Things-Maker/R.A.E.D/Upgrades/Heatbed Relay Wiring/relay.jpg

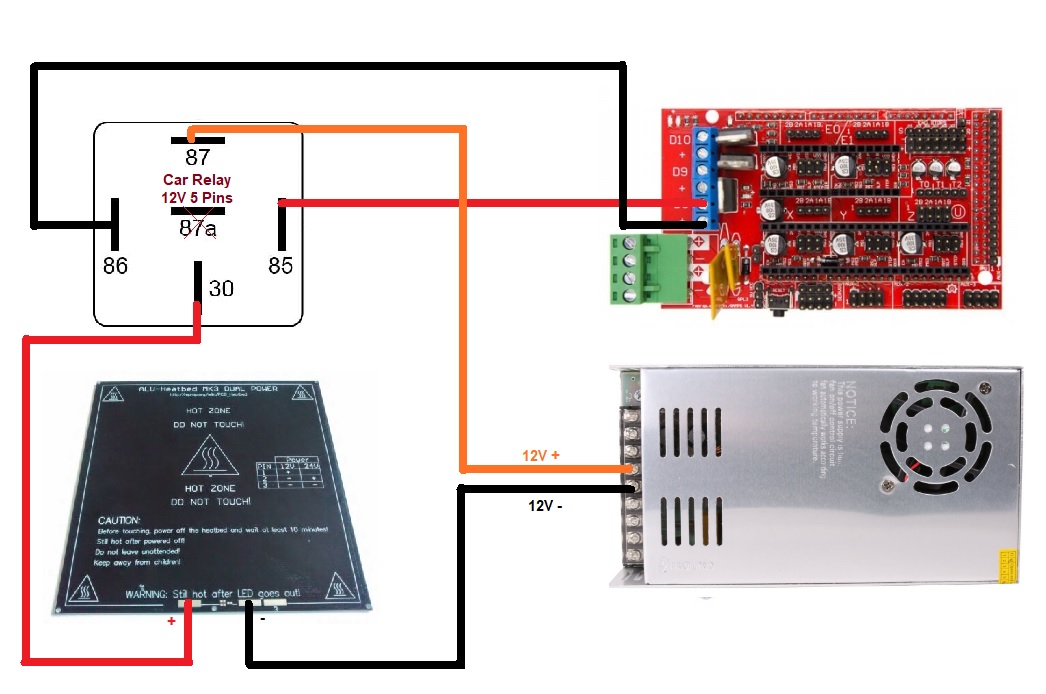
Upgrades/Heatbed Relay Wiring/relay.jpg
