Things-Maker/R.A.E.D/Upgrades/Autoleveling/Wiring/SN04abl.jpg

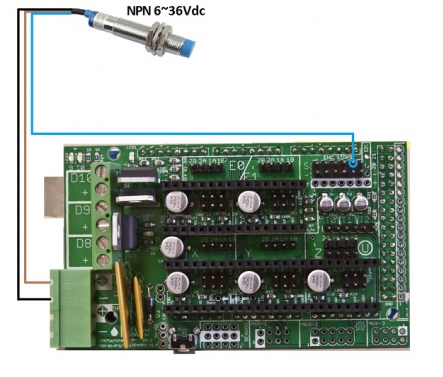
Upgrades/Autoleveling/Wiring/SN04abl.jpg
