Things-Maker/R.A.E.D/README.md

# R.A.E.D
 An Easy to build Tronxy X1 Style 3d printer that is designed to be cut by laser cutters
