Things-Maker/R.A.E.D/Pics/2.png

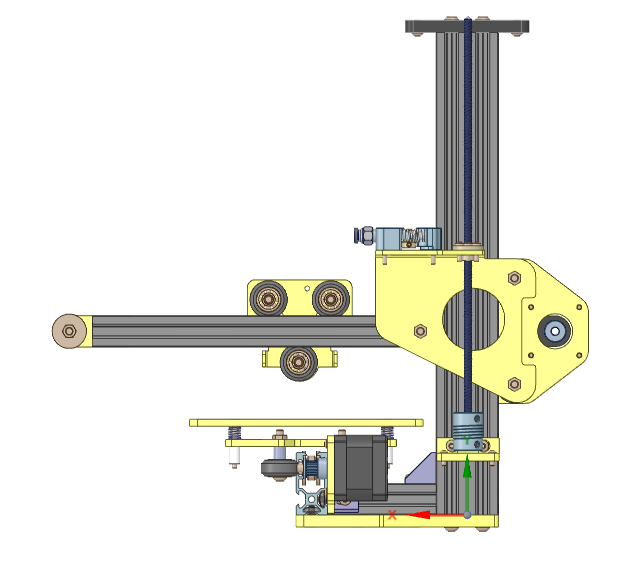
Pics/2.png
