Things-Maker/R.A.E.D/Pics/3.png

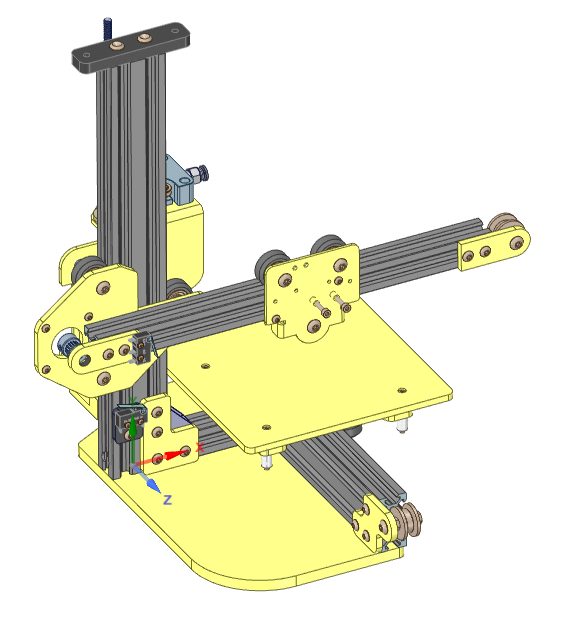
Pics/3.png
