Things-Maker/R.A.E.D/Upgrades/Bed_Tightner/bed.png

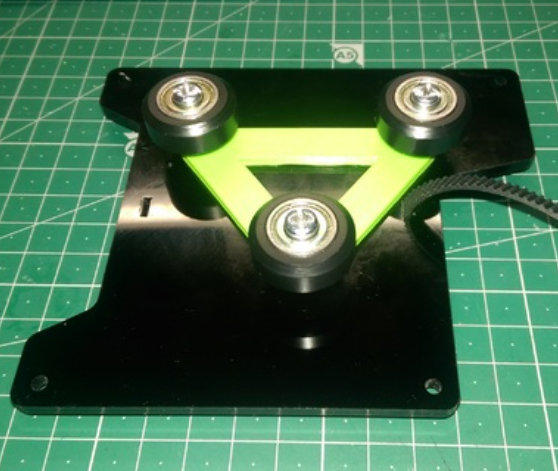
Upgrades/Bed_Tightner/bed.png
