Things-Maker/R.A.E.D/Upgrades/Belt_Tightner/tight.png

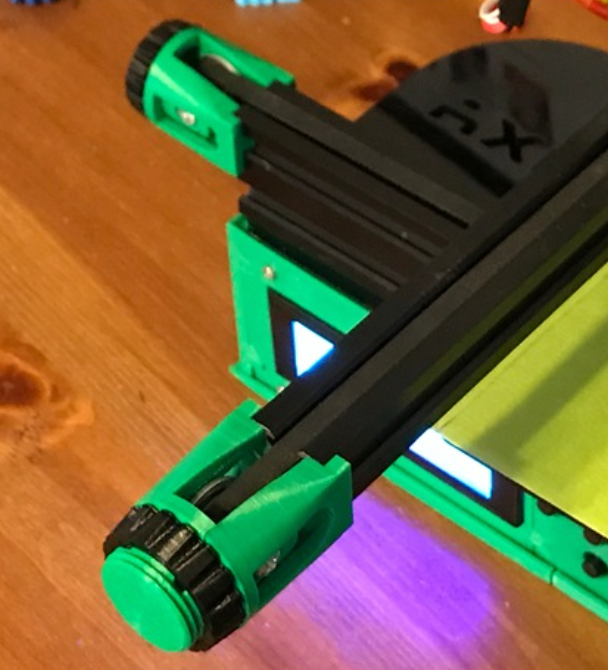
Upgrades/Belt_Tightner/tight.png
