Things-Maker/R.A.E.D/Upgrades/Extruder/New Extruder Bondtech/032b2cc936860b03048302d991c3498f.jpg

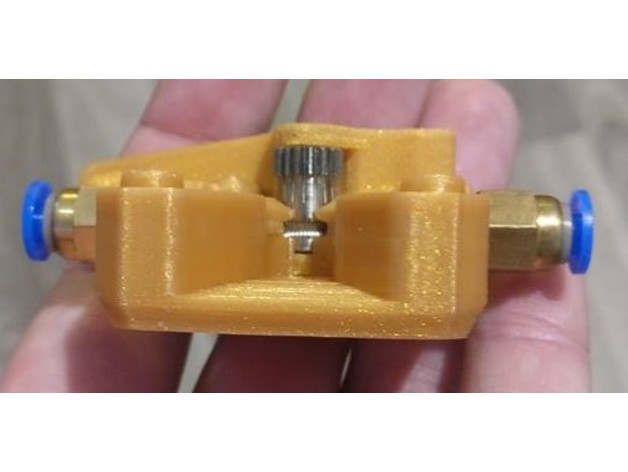
Upgrades/Extruder/New Extruder Bondtech/032b2cc936860b03048302d991c3498f.jpg
