Things-Maker/R.A.E.D/Upgrades/Extruder/New Extruder Bondtech/799bad5a3b514f096e69bbc4a7896cd9.jpg

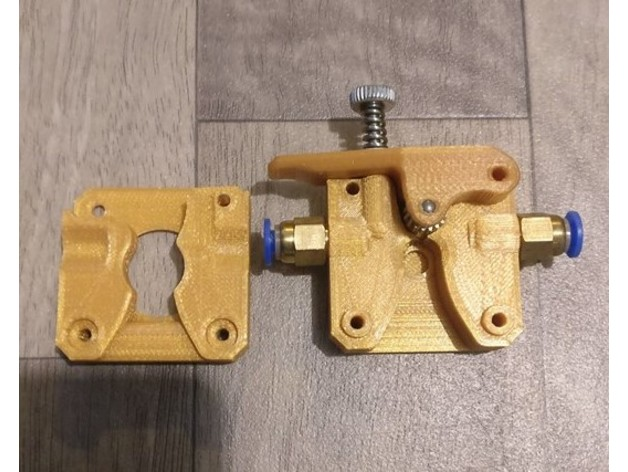
Upgrades/Extruder/New Extruder Bondtech/799bad5a3b514f096e69bbc4a7896cd9.jpg
