Things-Maker/R.A.E.D/Upgrades/Extruder/New Extruder Bondtech/156005c5baf40ff51a327f1c34f2975b.jpg

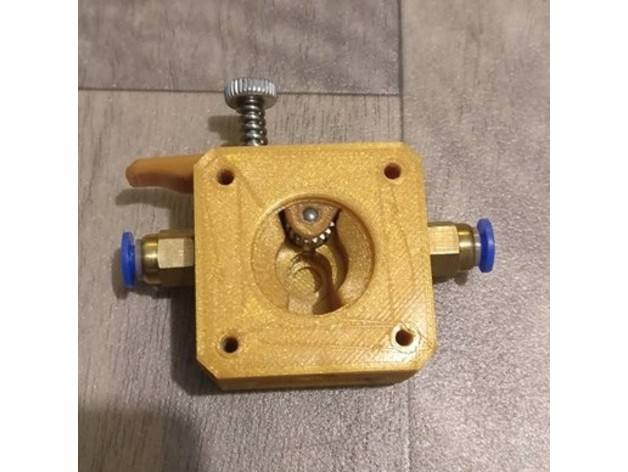
Upgrades/Extruder/New Extruder Bondtech/156005c5baf40ff51a327f1c34f2975b.jpg
