Things-Maker/R.A.E.D/Upgrades/Extruder/New Extruder Bondtech/d0096ec6c83575373e3a21d129ff8fef.jpg

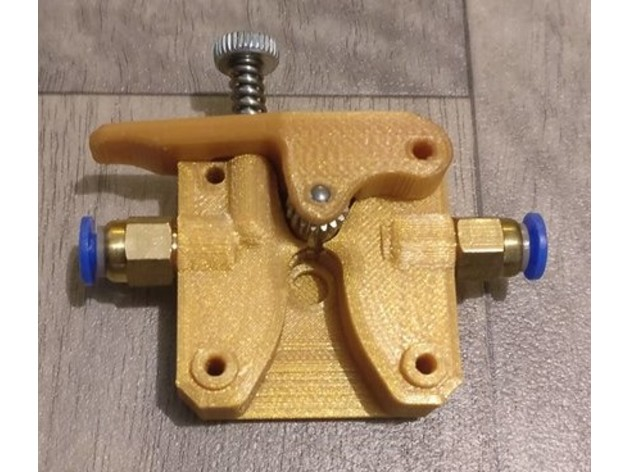
Upgrades/Extruder/New Extruder Bondtech/d0096ec6c83575373e3a21d129ff8fef.jpg
