Things-Maker/R.A.E.D/Upgrades/Extruder/New Extruder Bondtech/f3ccdd27d2000e3f9255a7e3e2c48800.jpg

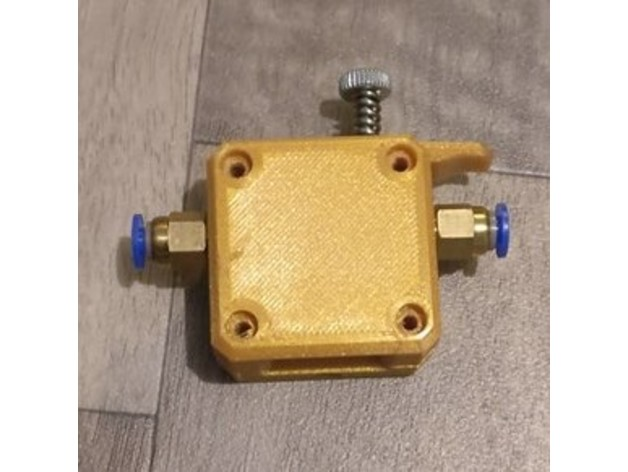
Upgrades/Extruder/New Extruder Bondtech/f3ccdd27d2000e3f9255a7e3e2c48800.jpg
