Things-Maker/R.A.E.D/Upgrades/Phone Holder (Camera-Octoprint)/Phone Holder.png

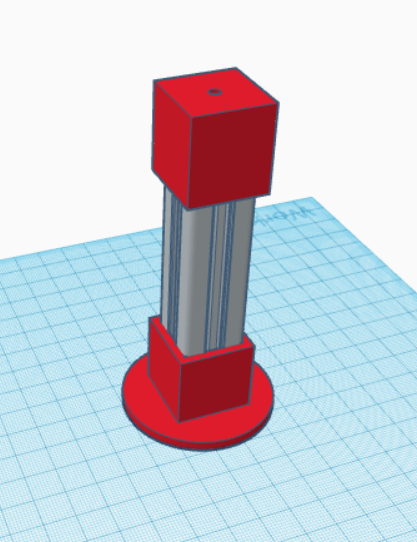
Upgrades/Phone Holder (Camera-Octoprint)/Phone Holder.png
