Things-Maker/R.A.E.D/Upgrades/Z_Carriage_Tightner/Z_tight.png

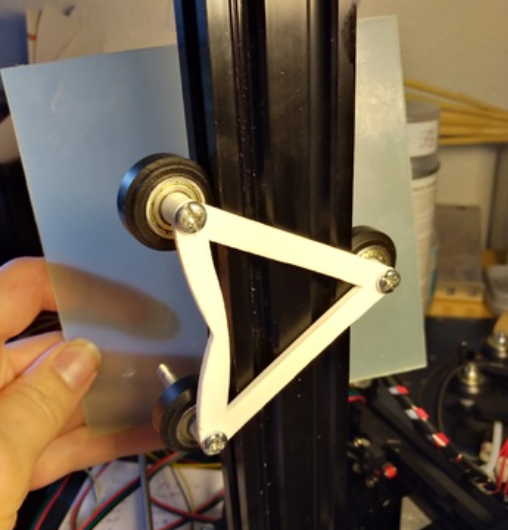
Upgrades/Z_Carriage_Tightner/Z_tight.png
