Things-Maker/R.A.E.D/Upgrades/Z_Motor_Mount/Z_Motor.png

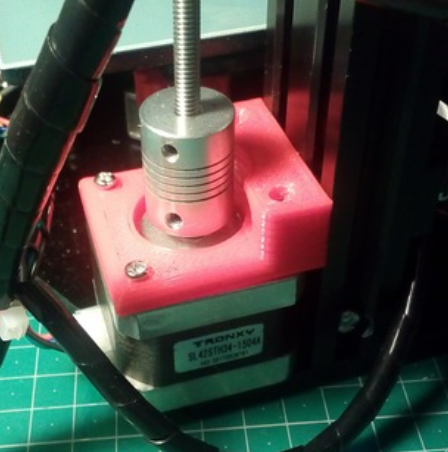
Upgrades/Z_Motor_Mount/Z_Motor.png
