Things-Maker/R.A.E.D/Upgrades/Z_X_Carriage/Z.png

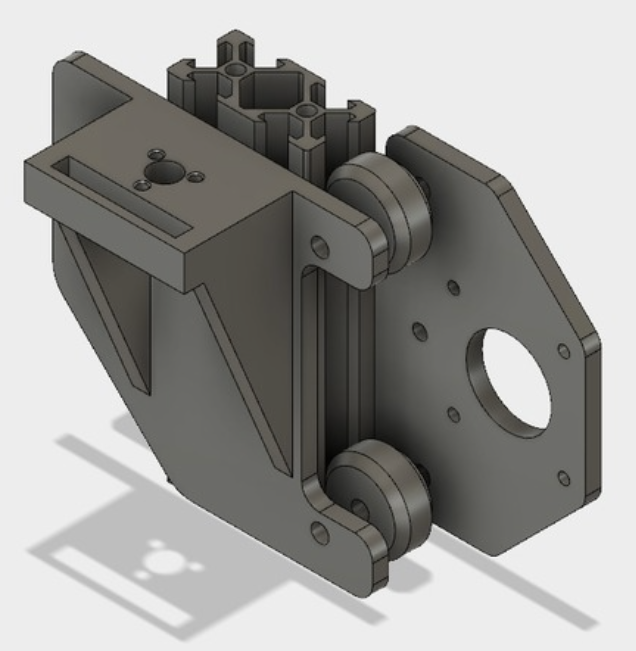
Upgrades/Z_X_Carriage/Z.png
