Things-Maker/R.A.E.D/Part_List/Part_List.xlsx

Part Name | Quantity | Price USD | Link
2040 Aluminum profile | 600mm Tslot or Vslot | 12.36 | https://bityl.co/FSdF
2020 Aluminum Profile | 400mm Tslot or Vslot | 5.38 | https://bityl.co/FSdF
Openbuilds Wheels (Big) | 9 | 7.12 | https://bityl.co/FSdO
GT2 Belt And Pully Kit | 1 | 3.34 | https://bityl.co/FSdY
Nema17 Motor | 3 | 8.16 | https://bityl.co/FSeJ
5x8 Shaft Coupler | 1 | 0.34 | https://bityl.co/FSeK
LeadScrew With Nut | 250mm - M8 | 3.96 | https://bityl.co/FSeP
Endstop Switchs | 3 | 1.12 | https://bityl.co/FSeZ
Full Assembled Extruder | 1 | 9.35 | https://bityl.co/FSfn
Metal Extruder Full Kit | 1 | 5.26 | https://bityl.co/FSfs
M4 M5 Nut Bolt Kit | 1 | 6.92 | https://bityl.co/FSfw
Electronics Kit | 1 | 17.85 | https://bityl.co/FSgy
Aluminum 2020 Corner Bracket | 10 | 2.01 | https://bityl.co/FSgY | Optional
X Carriage Plate with wheels | 1 | 3.87 | https://bityl.co/FSfd | Optional
Laser Cutting + Wood 6mm | 250x500mm | 18.5 | Local store | Optional
Power Supply | 12V 6Amp | 4 | https://bityl.co/FSh6 | Optional
 | TOTAL | 109.54
