Things-Maker/R.A.E.D/Calibration Steps/xyzCalibration_cube.stl

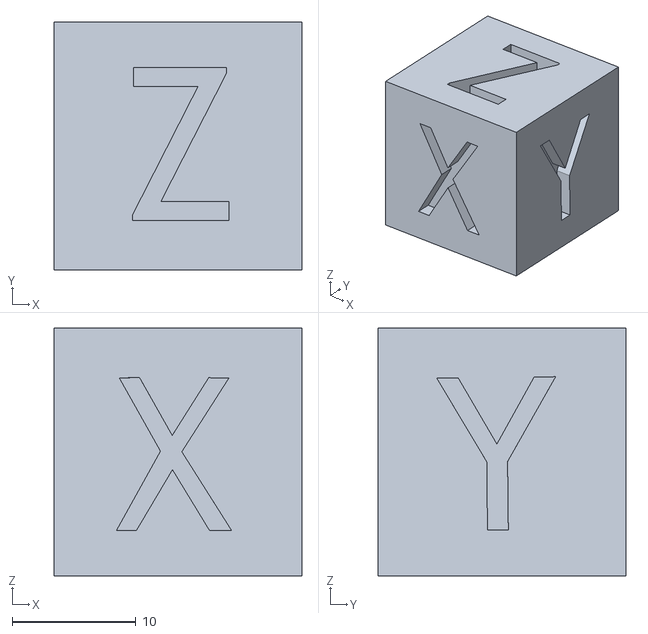
[picture p16: CAD file, 2023-03-04]
Calibration Steps/xyzCalibration_cube.stl
20.0 x 20.0 x 20.0
