Things-Maker/R.A.E.D/R.A.E.D_For_3DPrint/All_small_Parts.stl

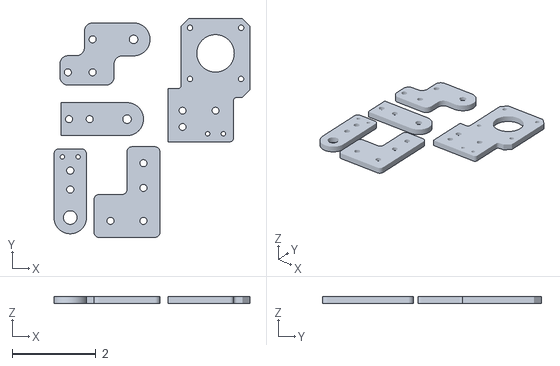
[picture p17: CAD file, 2023-03-04]
R.A.E.D_For_3DPrint/All_small_Parts.stl
4.68 x 5.22 x 0.177
