Things-Maker/R.A.E.D/Upgrades/Autoleveling/Mount/SN04_sensor_Mount.stl

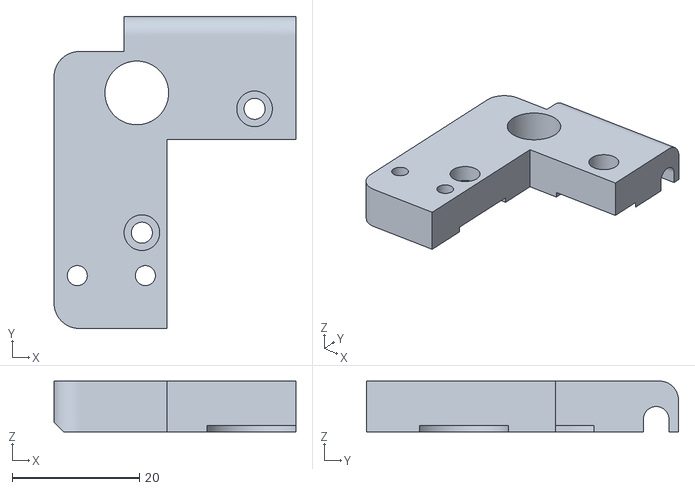
[picture p18: CAD file, 2023-03-04]
Upgrades/Autoleveling/Mount/SN04_sensor_Mount.stl
38.0 x 49.0 x 8.00
