Things-Maker/R.A.E.D/Upgrades/Bed_Tightner/bed_tightner_Up.stl

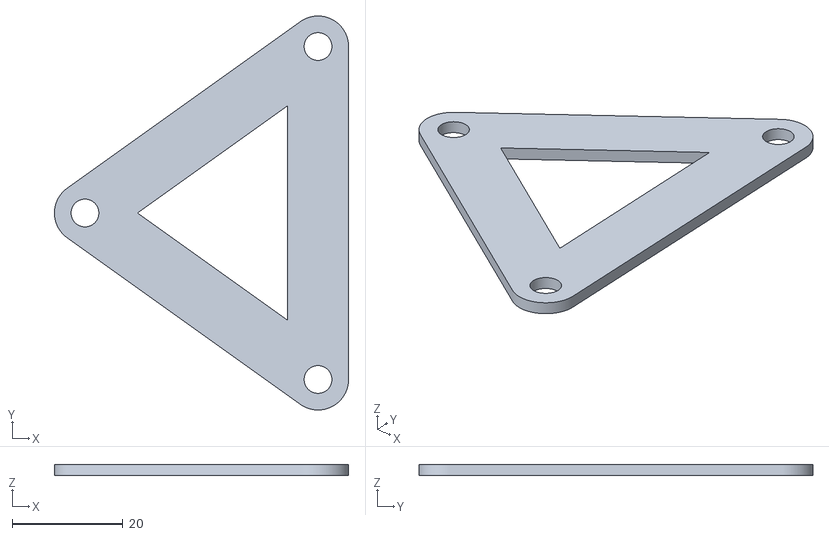
[picture p19: CAD file, 2023-03-04]
Upgrades/Bed_Tightner/bed_tightner_Up.stl
53.0 x 71.0 x 2.00
