Things-Maker/R.A.E.D/Upgrades/Electronics_Box/lcd_front.stl

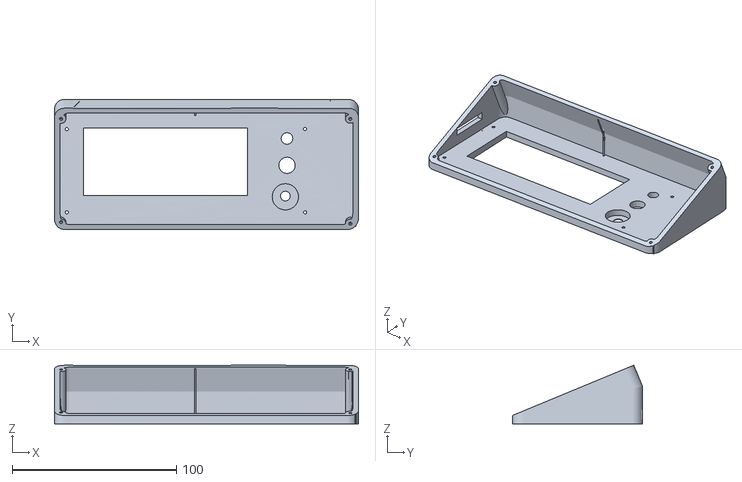
[picture p20: CAD file, 2023-03-04]
Upgrades/Electronics_Box/lcd_front.stl
185.0 x 79.2 x 35.6
