Things-Maker/R.A.E.D/Upgrades/Extruder/New Extruder Bondtech/STL/extruder-haut.STL

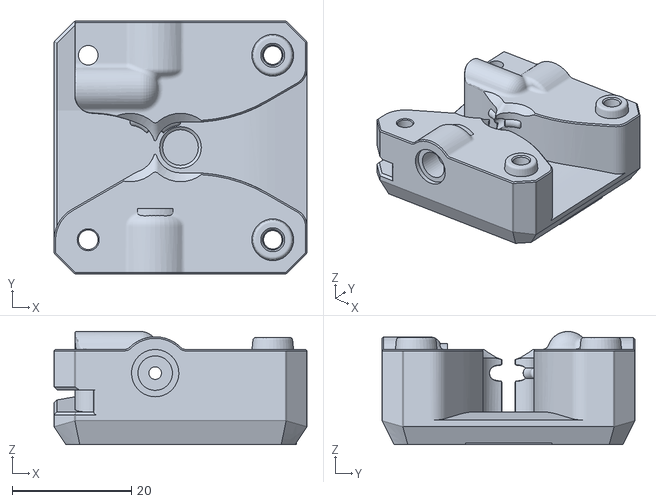
[picture p21: CAD file, 2023-03-04]
Upgrades/Extruder/New Extruder Bondtech/STL/extruder-haut.STL
42.5 x 42.5 x 19.0
