Things-Maker/R.A.E.D/Upgrades/Phone Holder (Camera-Octoprint)/Phone Holder.stl

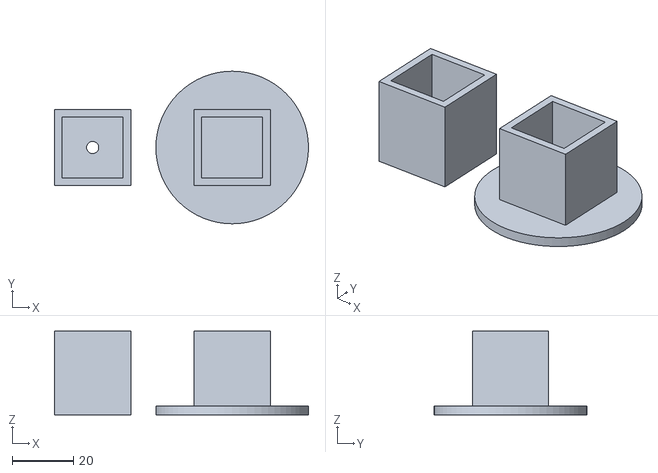
[picture p22: CAD file, 2023-03-04]
Upgrades/Phone Holder (Camera-Octoprint)/Phone Holder.stl
83.2 x 50.0 x 27.5
