Things-Maker/R.A.E.D/Upgrades/Z_Carriage_Tightner/Carriage_Tightner_2.stl

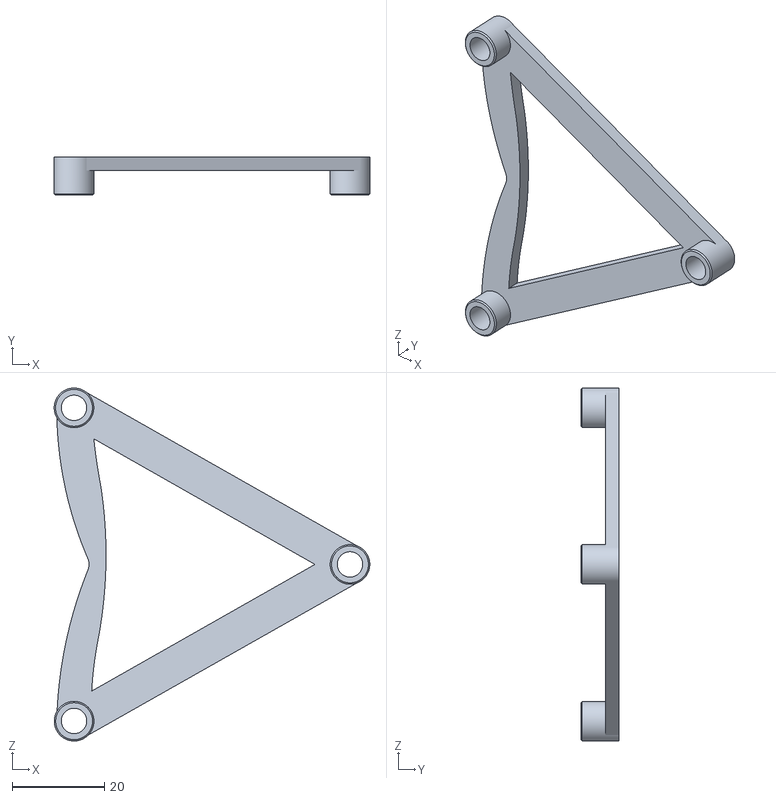
[picture p23: CAD file, 2023-03-04]
Upgrades/Z_Carriage_Tightner/Carriage_Tightner_2.stl
68.4 x 8.30 x 76.5
