Things-Maker/R.A.E.D/Upgrades/Z_Motor_Mount/z_motor_mount.stl

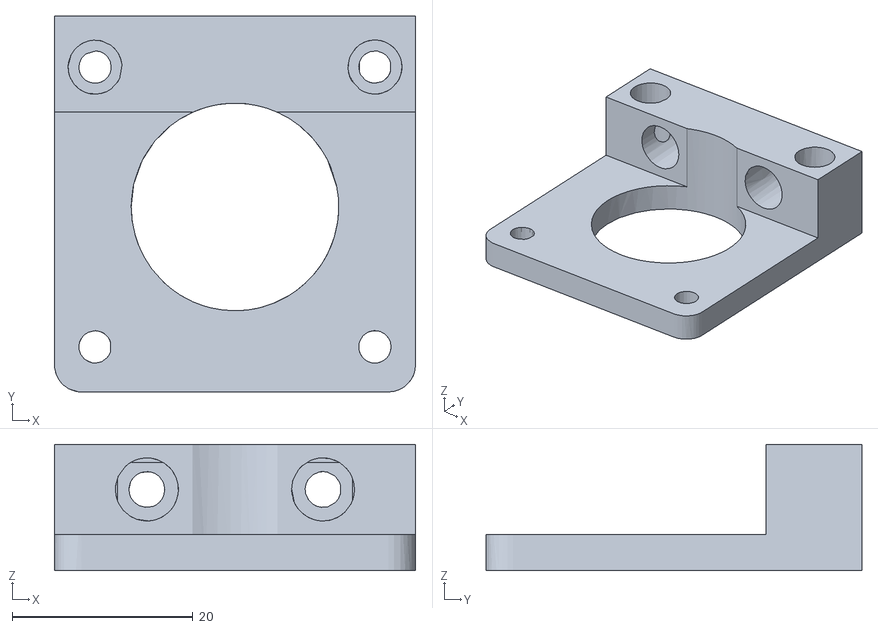
[picture p24: CAD file, 2023-03-04]
Upgrades/Z_Motor_Mount/z_motor_mount.stl
40.0 x 41.7 x 14.0
