Things-Maker/R.A.E.D/Upgrades/Z_X_Carriage/STL/Carriage_Upgrade_1.stl

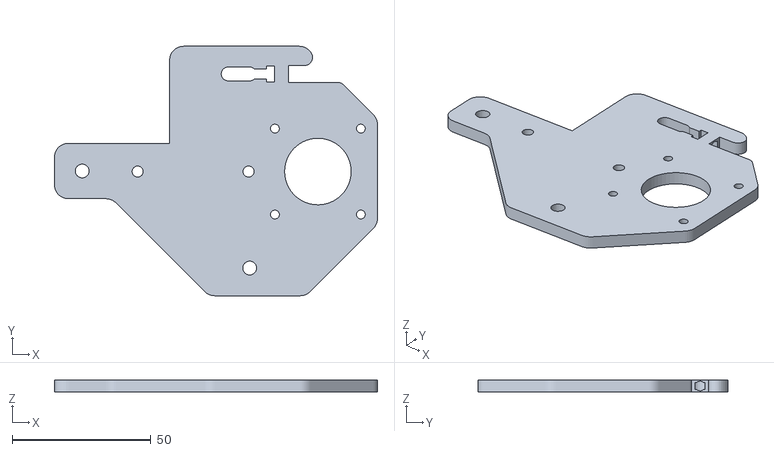
[picture p25: CAD file, 2023-03-04]
Upgrades/Z_X_Carriage/STL/Carriage_Upgrade_1.stl
116.5 x 90.0 x 4.50
