Things-Maker/R.A.E.D/R.A.E.D_For_3DPrint/Extruder.stl

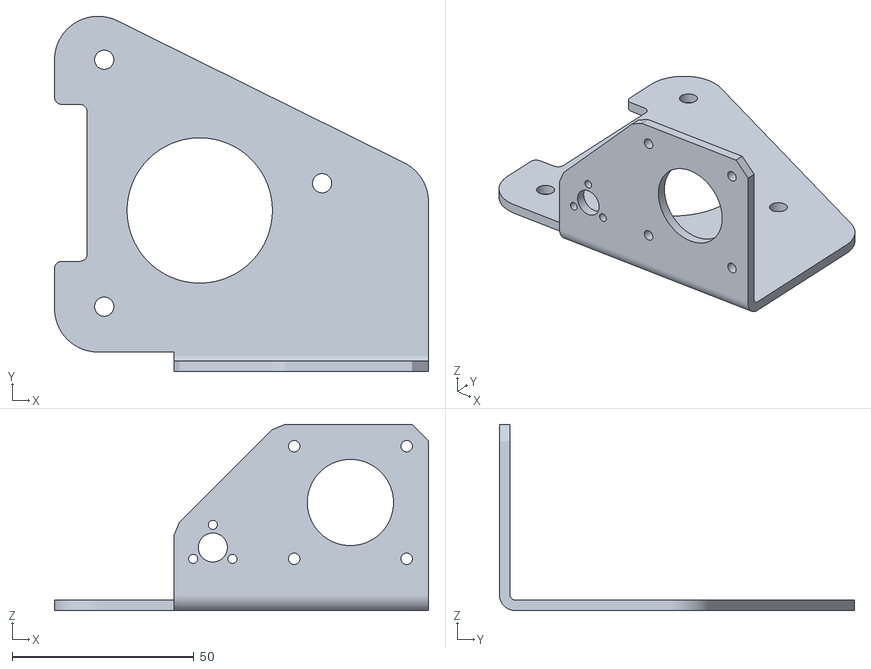
[picture p26: CAD file, 2023-03-04]
R.A.E.D_For_3DPrint/Extruder.stl
103.0 x 97.9 x 51.3
