Things-Maker/R.A.E.D/Upgrades/Bed_Tightner/bed_tightner_Down.stl

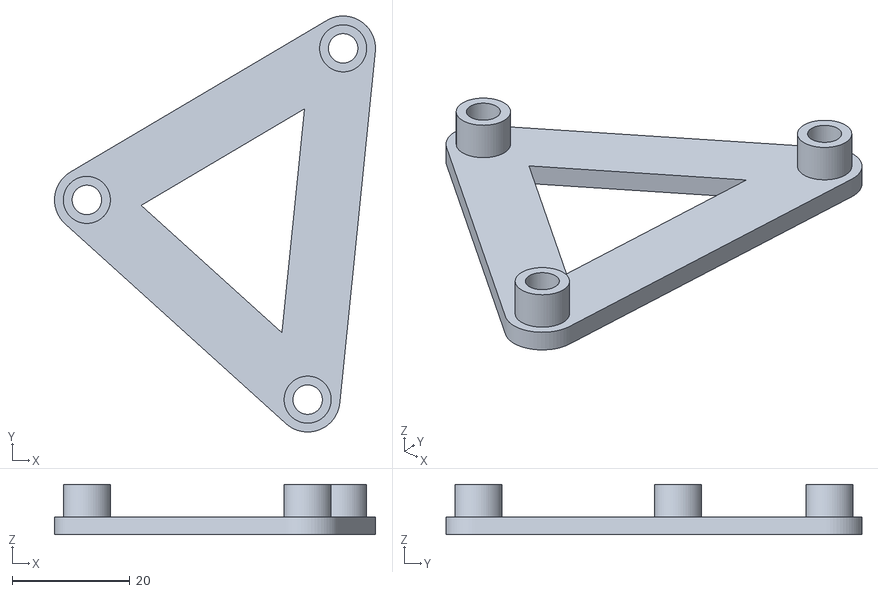
[picture p27: CAD file, 2023-03-04]
Upgrades/Bed_Tightner/bed_tightner_Down.stl
54.6 x 70.7 x 8.50
