Things-Maker/R.A.E.D/Upgrades/Electronics_Box/stop_button.stl

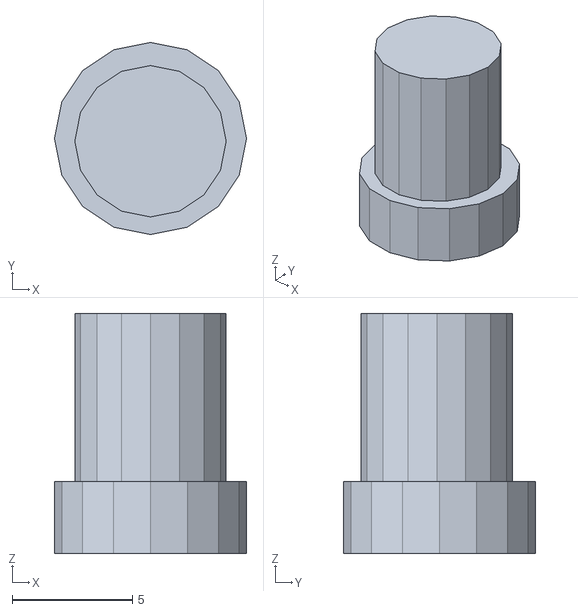
[picture p28: CAD file, 2023-03-04]
Upgrades/Electronics_Box/stop_button.stl
8.00 x 8.00 x 10.00
