Things-Maker/R.A.E.D/Upgrades/Extruder/New Extruder Bondtech/STL/extruder-languette.STL

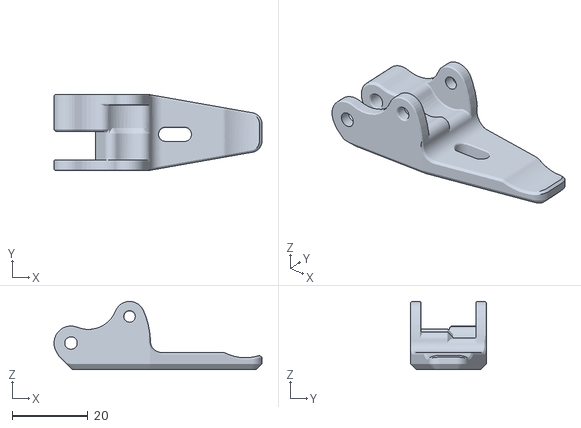
[picture p29: CAD file, 2023-03-04]
Upgrades/Extruder/New Extruder Bondtech/STL/extruder-languette.STL
55.0 x 20.0 x 18.0
