Things-Maker/R.A.E.D/Upgrades/Z_X_Carriage/STL/Carriage_Upgrade_2.stl

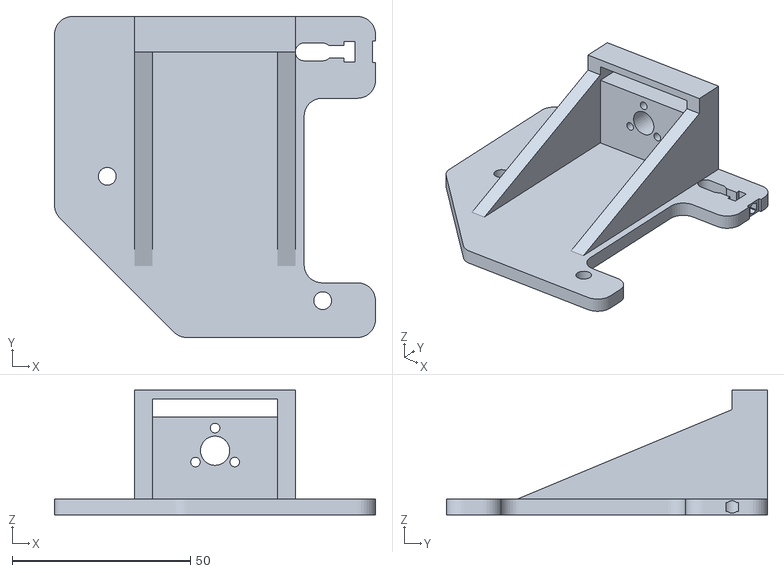
[picture p30: CAD file, 2023-03-04]
Upgrades/Z_X_Carriage/STL/Carriage_Upgrade_2.stl
90.0 x 90.0 x 35.0
