Things-Maker/R.A.E.D/R.A.E.D_For_3DPrint/Bed_Plate.stl

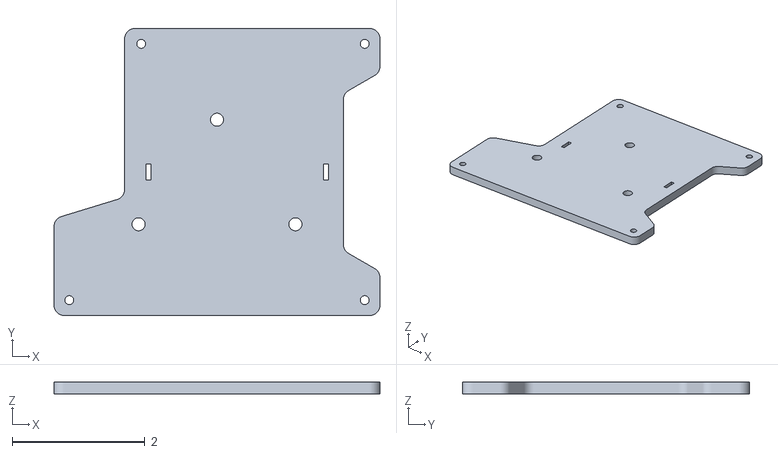
[picture p31: CAD file, 2023-03-04]
R.A.E.D_For_3DPrint/Bed_Plate.stl
4.91 x 4.32 x 0.177
