Things-Maker/R.A.E.D/Upgrades/Electronics_Box/lcd_base.stl

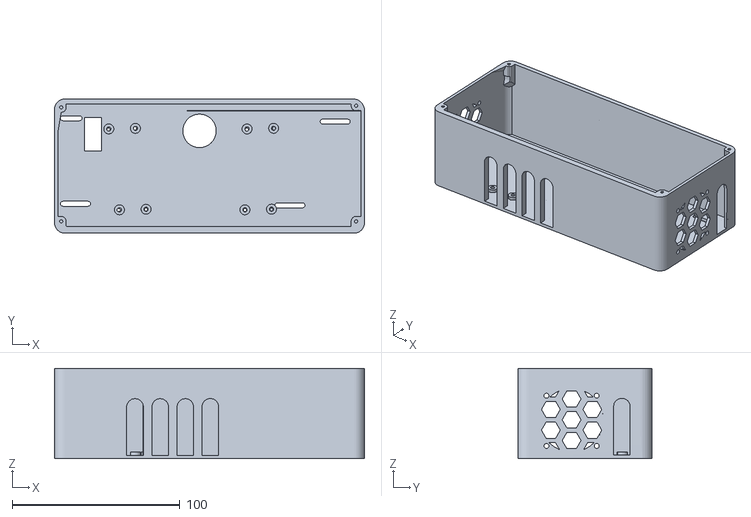
[picture p32: CAD file, 2023-03-04]
Upgrades/Electronics_Box/lcd_base.stl
185.0 x 80.1 x 54.0
