Things-Maker/R.A.E.D/Upgrades/Extruder/New Extruder Bondtech/STL/extruder-bas.STL

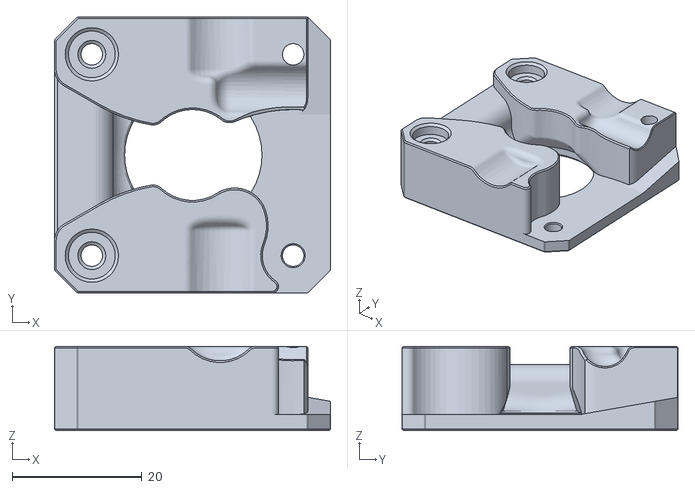
[picture p33: CAD file, 2023-03-04]
Upgrades/Extruder/New Extruder Bondtech/STL/extruder-bas.STL
42.5 x 42.5 x 13.0
