Things-Maker/R.A.E.D/R.A.E.D_For_3DPrint/Z_rail1.stl

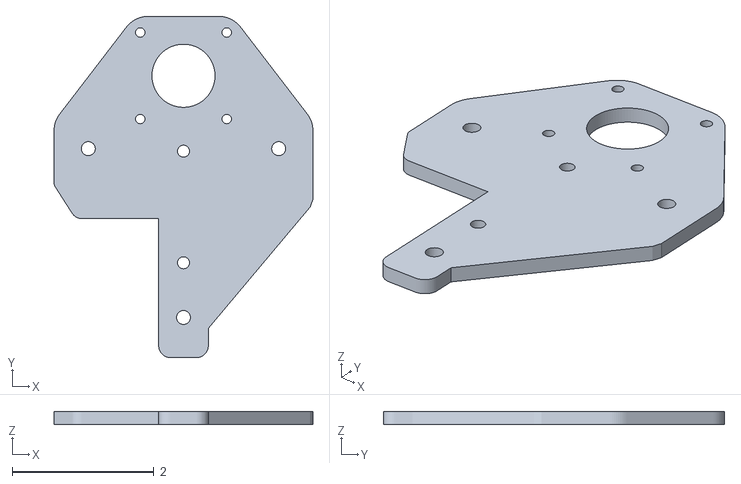
[picture p34: CAD file, 2023-03-04]
R.A.E.D_For_3DPrint/Z_rail1.stl
3.65 x 4.81 x 0.177
