Things-Maker/R.A.E.D/R.A.E.D_For_3DPrint/Motor z.stl

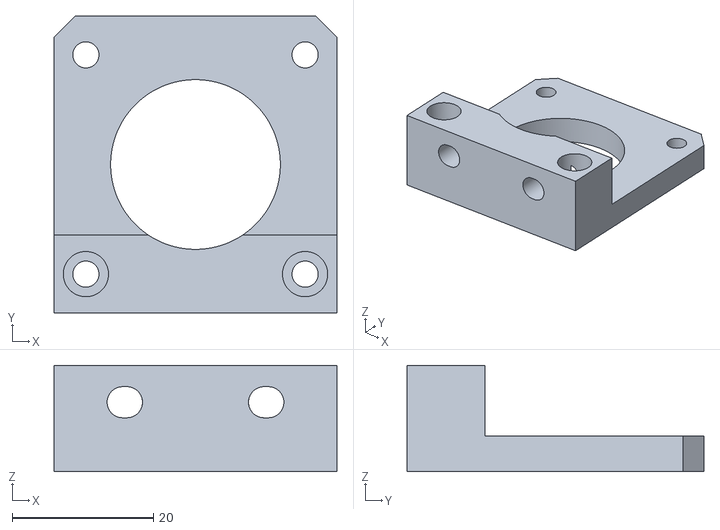
[picture p35: CAD file, 2023-03-04]
R.A.E.D_For_3DPrint/Motor z.stl
40.0 x 42.0 x 15.0
