Things-Maker/R.A.E.D/(list of files, cad)

Other CAD files:
Upgrades/Extruder/Old Extruder/Extruder_Motor_Holder.stl
