Things-Maker/R.A.E.D/Ramps1.4_Wring/Wiring.png

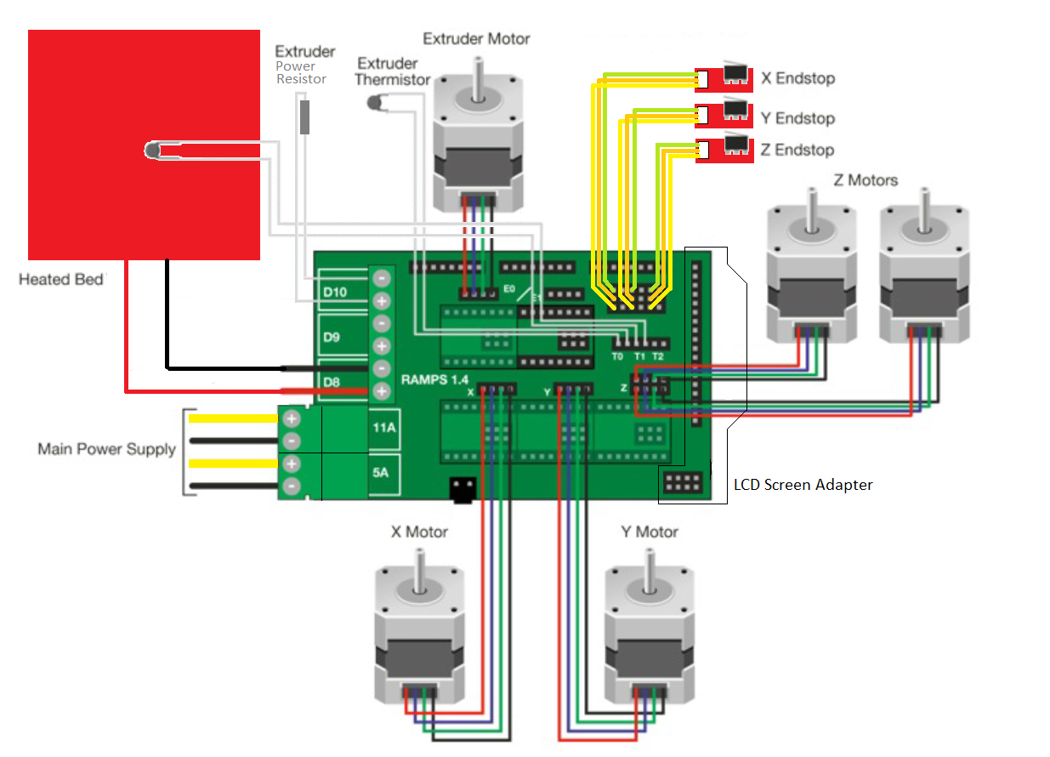
Ramps1.4_Wring/Wiring.png
