Things-Maker/R.A.E.D/R.A.E.D_For_Hand_Cutting/X-Carriage_Belt_Fix_Stronger.pdf

# X Carriage V2

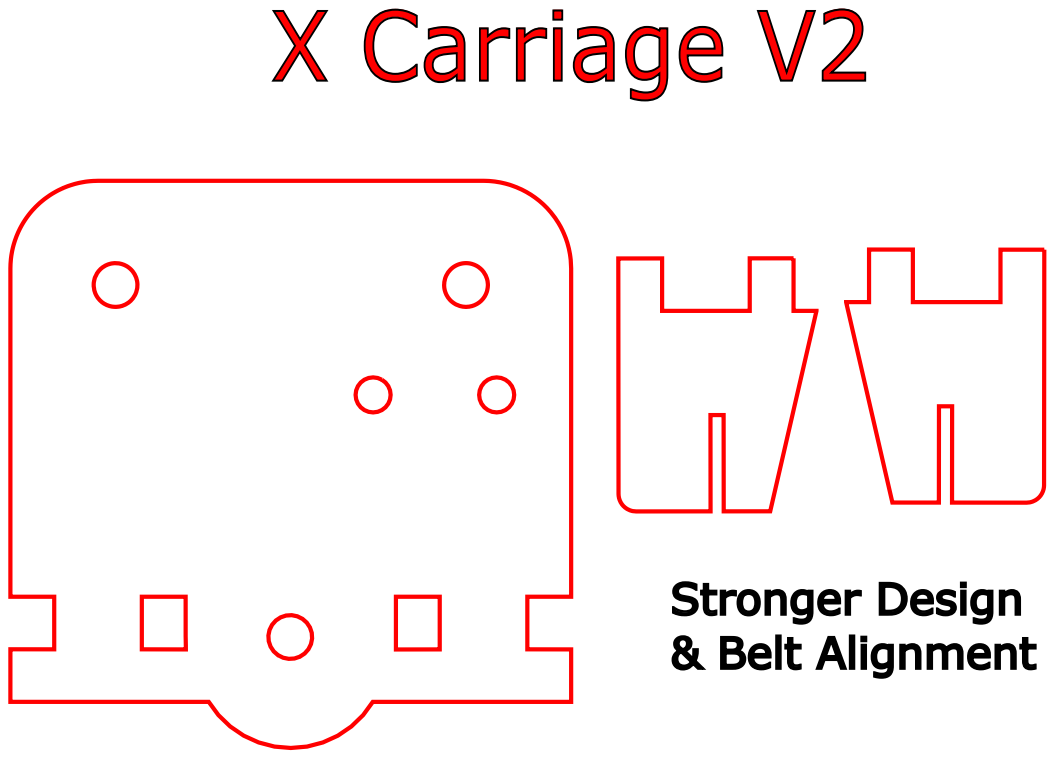
[picture p37: page 1]
Stronger Design & Belt Alignment
