Things-Maker/R.A.E.D/R.A.E.D_For_Hand_Cutting/1.pdf

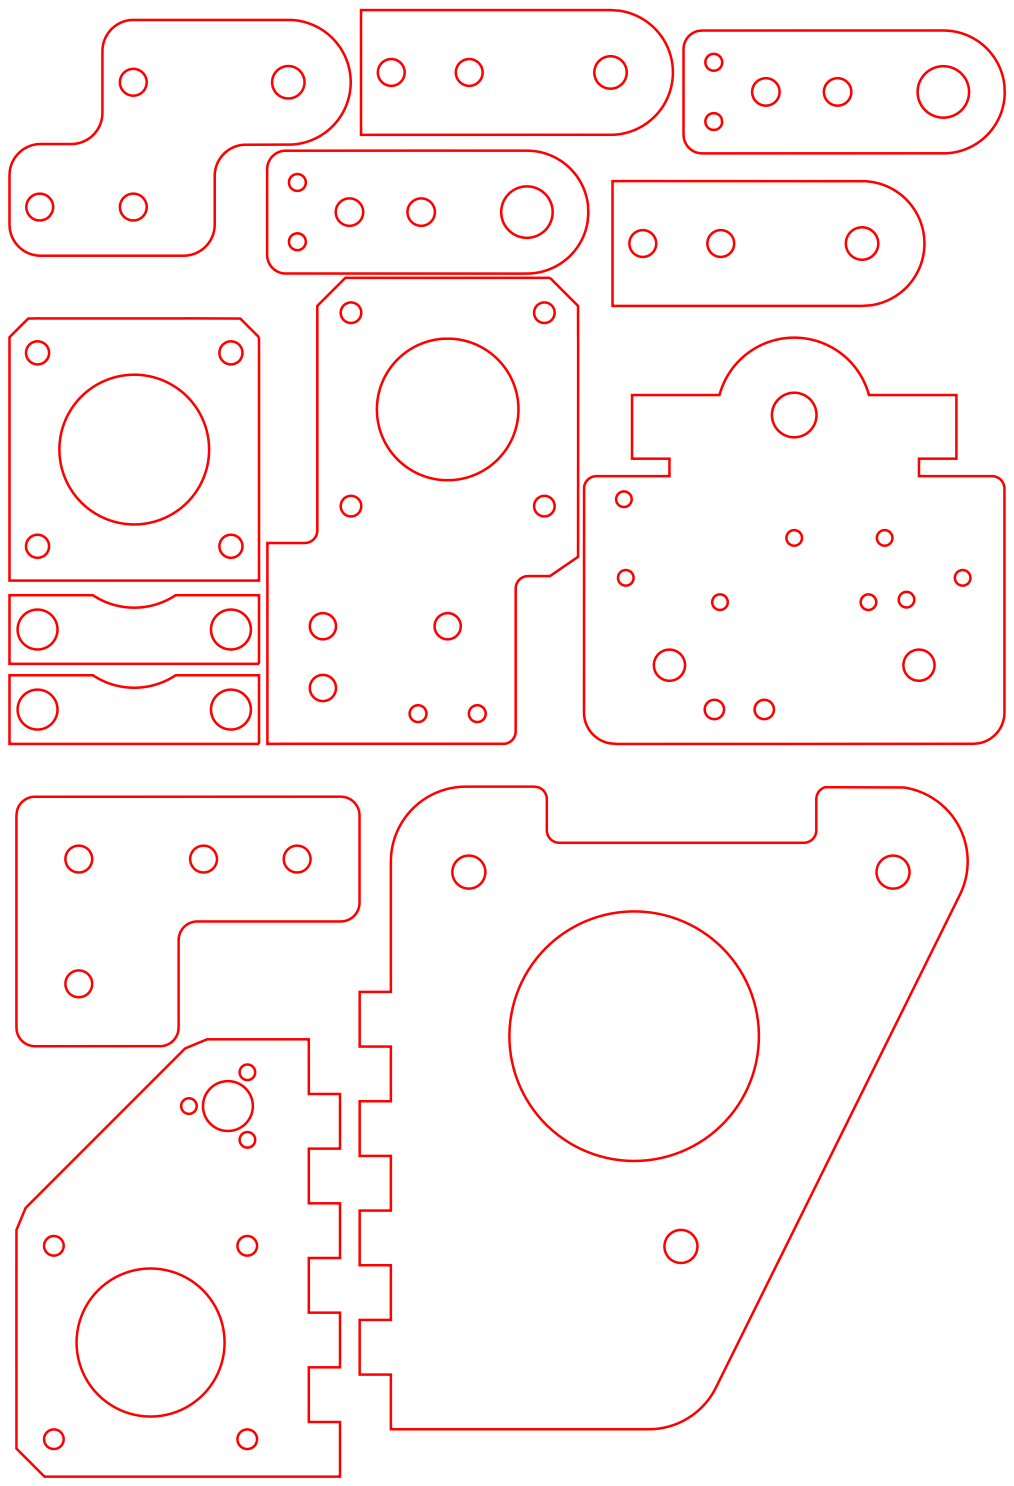
[picture p38: page 1]
