Things-Maker/R.A.E.D/R.A.E.D_For_Hand_Cutting/2.pdf

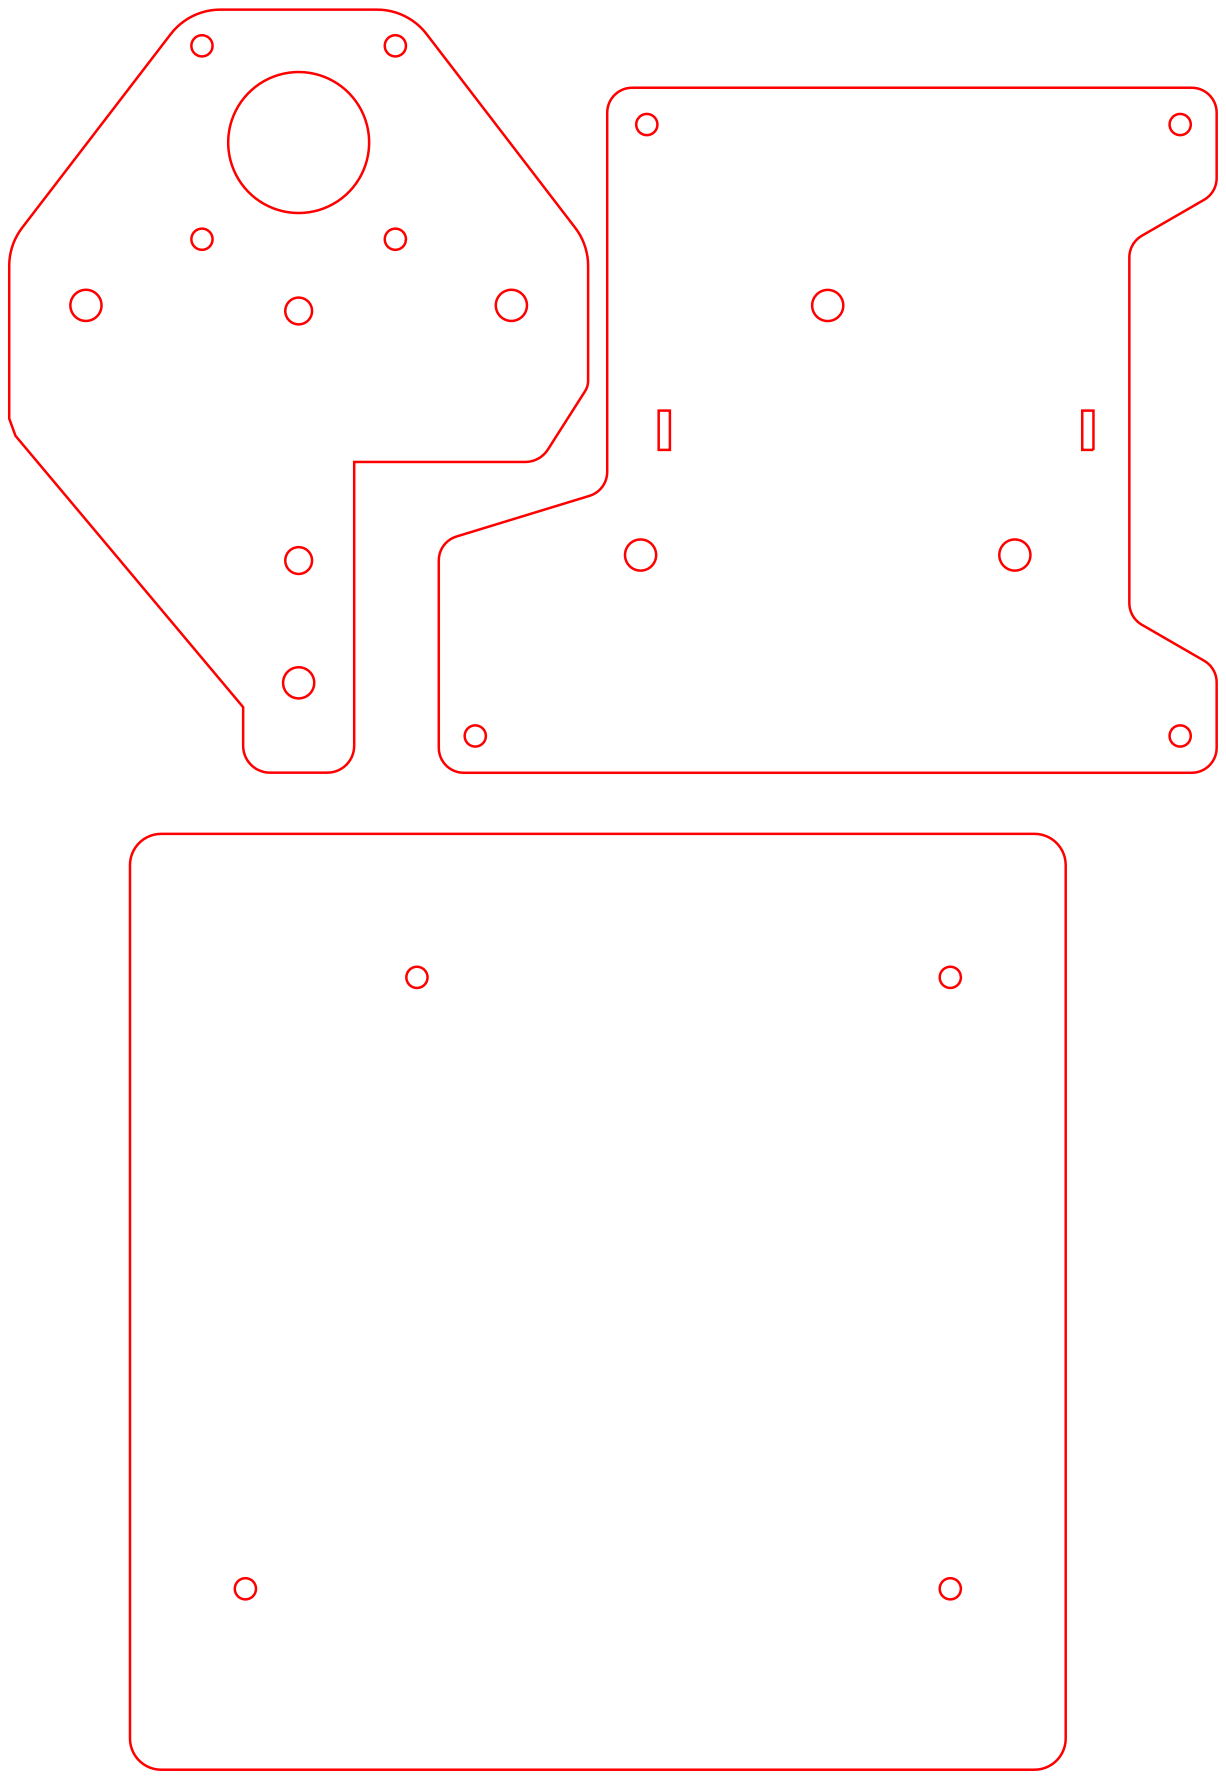
[picture p39: page 1]
