Things-Maker/R.A.E.D/R.A.E.D_For_Hand_Cutting/3.pdf

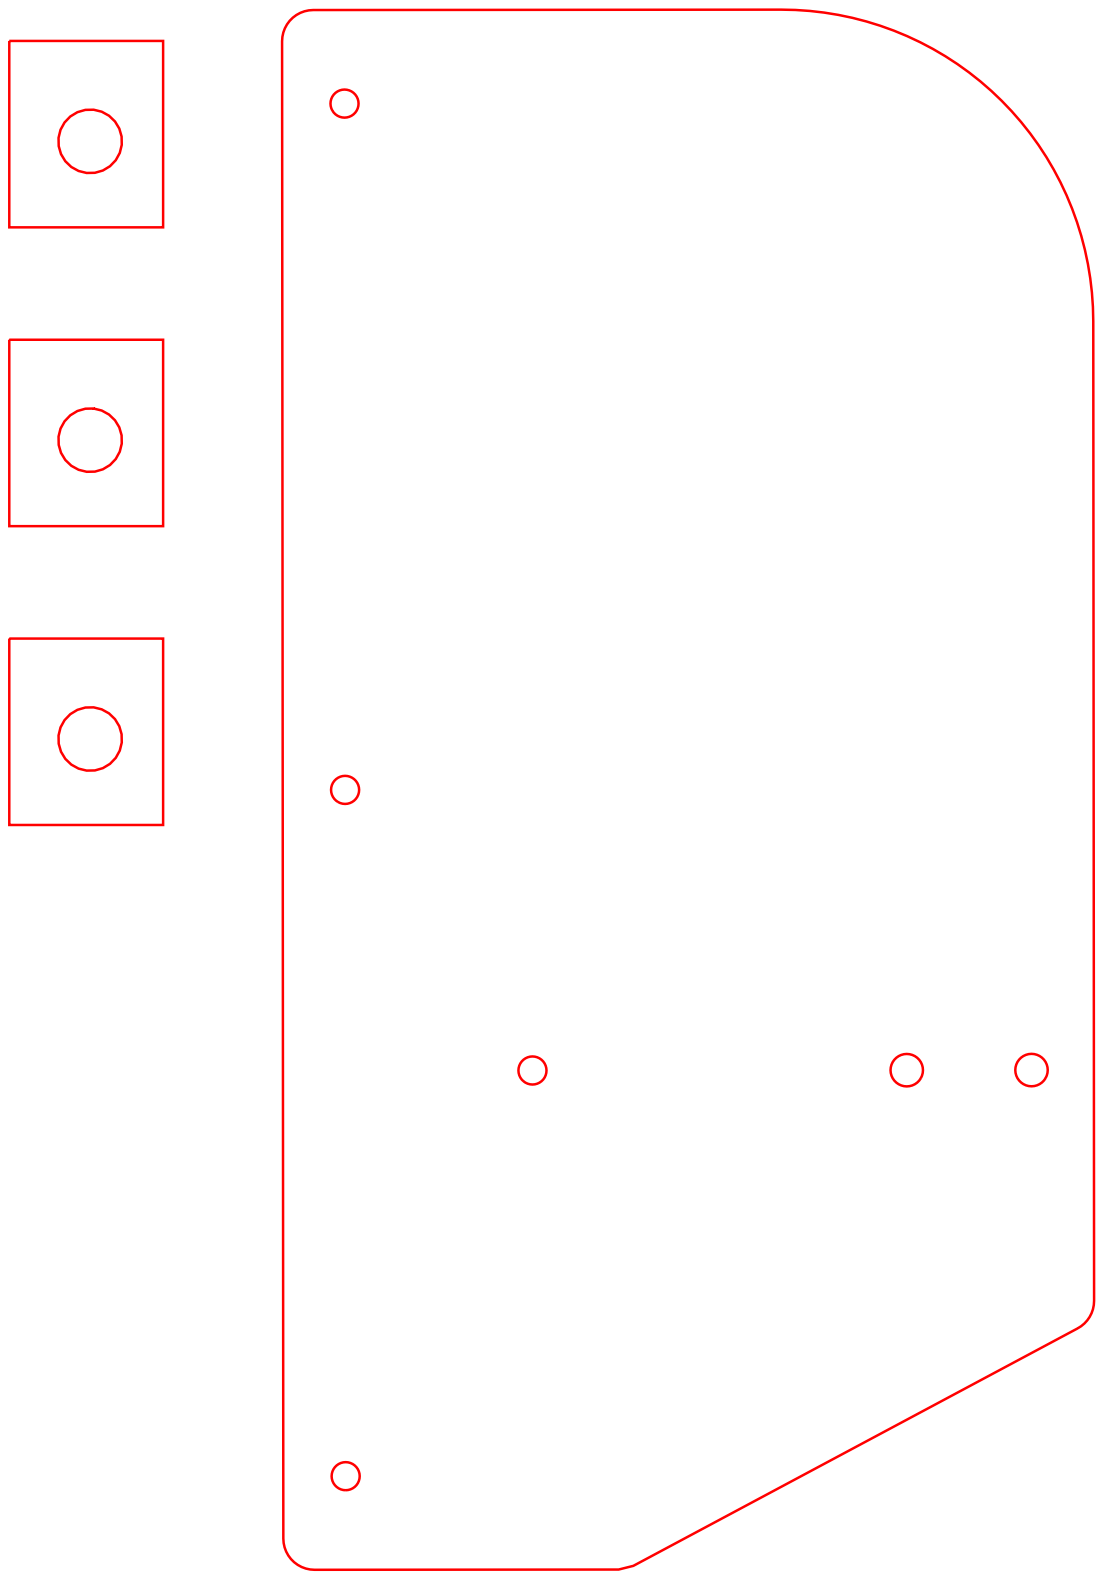
[picture p40: page 1]
