Things-Maker/R.A.E.D/Ramps1.4_Code/Auto_Bed_leveling/Marlin/Configuration.h

#define CONFIGURATION_H
#define CONFIGURATION_H_VERSION 010109
#define STRING_CONFIG_H_AUTHOR "(Claus Naeveke, 0.1)" // Who made the changes.
#define SHOW_BOOTSCREEN
#define STRING_SPLASH_LINE1 SHORT_BUILD_VERSION // will be shown during bootup in line 1
#define STRING_SPLASH_LINE2 WEBSITE_URL         // will be shown during bootup in line 2
#define SERIAL_PORT 0
#define BAUDRATE 115200
  #define MOTHERBOARD BOARD_RAMPS_14_EFB
#define CUSTOM_MACHINE_NAME "R.A.E.D"
#define EXTRUDERS 1
#define DEFAULT_NOMINAL_FILAMENT_DIA 1.75
#define POWER_SUPPLY 0
#define TEMP_SENSOR_0 11
#define TEMP_SENSOR_1 0
#define TEMP_SENSOR_2 0
#define TEMP_SENSOR_3 0
#define TEMP_SENSOR_4 0
#define TEMP_SENSOR_BED 1
#define TEMP_SENSOR_CHAMBER 0
#define DUMMY_THERMISTOR_998_VALUE 25
#define DUMMY_THERMISTOR_999_VALUE 100
#define MAX_REDUNDANT_TEMP_SENSOR_DIFF 10
#define TEMP_RESIDENCY_TIME 10  // (seconds)
#define TEMP_HYSTERESIS 3       // (degC) range of +/- temperatures considered "close" to the target one
#define TEMP_WINDOW     1       // (degC) Window around target to start the residency timer x degC early.
#define TEMP_BED_RESIDENCY_TIME 10  // (seconds)
#define TEMP_BED_HYSTERESIS 3       // (degC) range of +/- temperatures considered "close" to the target one
#define TEMP_BED_WINDOW     1       // (degC) Window around target to start the residency timer x degC early.
#define HEATER_0_MINTEMP 5
#define HEATER_1_MINTEMP 5
#define HEATER_2_MINTEMP 5
#define HEATER_3_MINTEMP 5
#define HEATER_4_MINTEMP 5
#define BED_MINTEMP 5
#define HEATER_0_MAXTEMP 260
#define HEATER_1_MAXTEMP 260
#define HEATER_2_MAXTEMP 260
#define HEATER_3_MAXTEMP 260
#define HEATER_4_MAXTEMP 260
#define BED_MAXTEMP 150
#define PIDTEMP
#define BANG_MAX 255     // Limits current to nozzle while in bang-bang mode; 255=full current
#define PID_MAX BANG_MAX // Limits current to nozzle while PID is active (see PID_FUNCTIONAL_RANGE below); 255=full current
#define PID_K1 0.95      // Smoothing factor within any PID loop
  #define PID_FUNCTIONAL_RANGE 10 // If the temperature difference between the target temperature and the actual temperature
  #define DEFAULT_Kp 16.20
  #define DEFAULT_Ki 1.11
  #define DEFAULT_Kd 59.06
#define MAX_BED_POWER 255 // limits duty cycle to bed; 255=full current
#define PREVENT_COLD_EXTRUSION
#define EXTRUDE_MINTEMP 170
#define PREVENT_LENGTHY_EXTRUDE
#define EXTRUDE_MAXLENGTH 200
#define THERMAL_PROTECTION_HOTENDS // Enable thermal protection for all extruders
#define THERMAL_PROTECTION_BED     // Enable thermal protection for the heated bed
#define USE_XMIN_PLUG
#define USE_YMIN_PLUG
#define USE_ZMIN_PLUG
#define ENDSTOPPULLUPS
#define X_MIN_ENDSTOP_INVERTING false  // set to true to invert the logic of the endstop.
#define Y_MIN_ENDSTOP_INVERTING true  // set to true to invert the logic of the endstop.
#define Z_MIN_ENDSTOP_INVERTING true  // set to true to invert the logic of the endstop.
#define X_MAX_ENDSTOP_INVERTING false // set to true to invert the logic of the endstop.
#define Y_MAX_ENDSTOP_INVERTING false // set to true to invert the logic of the endstop.
#define Z_MAX_ENDSTOP_INVERTING false // set to true to invert the logic of the endstop.
#define Z_MIN_PROBE_ENDSTOP_INVERTING true // set to true to invert the logic of the probe.
#define DEFAULT_AXIS_STEPS_PER_UNIT   { 82.07, 46.28, 1737.24, 139.3 }
#define DEFAULT_MAX_FEEDRATE          { 400, 400, 2, 50 }
#define DEFAULT_MAX_ACCELERATION      { 200, 200, 40, 5000 }
#define DEFAULT_ACCELERATION          3000    // X, Y, Z and E acceleration for printing moves
#define DEFAULT_RETRACT_ACCELERATION  3000    // E acceleration for retracts
#define DEFAULT_TRAVEL_ACCELERATION   3000    // X, Y, Z acceleration for travel (non printing) moves
#define DEFAULT_XJERK                 20.0
#define DEFAULT_YJERK                 20.0
#define DEFAULT_ZJERK                  0.3
#define DEFAULT_EJERK                  5.0
#define Z_MIN_PROBE_USES_Z_MIN_ENDSTOP_PIN
#define FIX_MOUNTED_PROBE
#define X_PROBE_OFFSET_FROM_EXTRUDER -40  // X offset: -left  +right  [of the nozzle]
#define Y_PROBE_OFFSET_FROM_EXTRUDER -7  // Y offset: -front +behind [the nozzle]
#define Z_PROBE_OFFSET_FROM_EXTRUDER -2.75   // Z offset: -below +above  [the nozzle]
#define MIN_PROBE_EDGE 40
#define XY_PROBE_SPEED 8000
#define Z_PROBE_SPEED_FAST HOMING_FEEDRATE_Z
#define Z_PROBE_SPEED_SLOW (Z_PROBE_SPEED_FAST / 2)
#define Z_CLEARANCE_DEPLOY_PROBE   5 // Z Clearance for Deploy/Stow
#define Z_CLEARANCE_BETWEEN_PROBES  5 // Z Clearance between probe points
#define Z_CLEARANCE_MULTI_PROBE     5 // Z Clearance between multiple probes
#define Z_PROBE_LOW_POINT          -2 // Farthest distance below the trigger-point to go before stopping
#define Z_PROBE_OFFSET_RANGE_MIN -20
#define Z_PROBE_OFFSET_RANGE_MAX 20
#define X_ENABLE_ON 0
#define Y_ENABLE_ON 0
#define Z_ENABLE_ON 0
#define E_ENABLE_ON 0 // For all extruders
#define DISABLE_X false
#define DISABLE_Y false
#define DISABLE_Z false
#define DISABLE_E false // For all extruders
#define DISABLE_INACTIVE_EXTRUDER true // Keep only the active extruder enabled.
#define INVERT_X_DIR false
#define INVERT_Y_DIR false
#define INVERT_Z_DIR true
#define INVERT_E0_DIR false
#define INVERT_E1_DIR false
#define INVERT_E2_DIR false
#define INVERT_E3_DIR false
#define INVERT_E4_DIR false
#define Z_HOMING_HEIGHT 2  // (in mm) Minimal z height before homing (G28) for Z clearance above the bed, clamps, ...
#define X_HOME_DIR -1
#define Y_HOME_DIR -1
#define Z_HOME_DIR -1
#define X_BED_SIZE 140
#define Y_BED_SIZE 120
#define X_MIN_POS 0
#define Y_MIN_POS 0
#define Z_MIN_POS 0
#define X_MAX_POS X_BED_SIZE
#define Y_MAX_POS Y_BED_SIZE
#define Z_MAX_POS 150
#define MAX_SOFTWARE_ENDSTOPS
  #define MAX_SOFTWARE_ENDSTOP_X
  #define MAX_SOFTWARE_ENDSTOP_Y
  #define MAX_SOFTWARE_ENDSTOP_Z
#define AUTO_BED_LEVELING_BILINEAR
#define RESTORE_LEVELING_AFTER_G28
  #define ENABLE_LEVELING_FADE_HEIGHT
  #define SEGMENT_LEVELED_MOVES
  #define LEVELED_SEGMENT_LENGTH 5.0 // (mm) Length of all segments (except the last one)
  #define G26_MESH_VALIDATION
    #define MESH_TEST_NOZZLE_SIZE     0.4   // (mm) Diameter of primary nozzle.
    #define MESH_TEST_LAYER_HEIGHT    0.2   // (mm) Default layer height for the G26 Mesh Validation Tool.
    #define MESH_TEST_HOTEND_TEMP   205.0   // (°C) Default nozzle temperature for the G26 Mesh Validation Tool.
    #define MESH_TEST_BED_TEMP       60.0   // (°C) Default bed temperature for the G26 Mesh Validation Tool.
  #define GRID_MAX_POINTS_X 3
  #define GRID_MAX_POINTS_Y GRID_MAX_POINTS_X
  #define LEFT_PROBE_BED_POSITION 40
  #define RIGHT_PROBE_BED_POSITION 100
  #define FRONT_PROBE_BED_POSITION 40
  #define BACK_PROBE_BED_POSITION 80
#define LCD_BED_LEVELING
  #define MBL_Z_STEP 0.025    // Step size while manually probing Z axis.
  #define LCD_PROBE_Z_RANGE 4 // Z Range centered on Z_MIN_POS for LCD Z adjustment
#define LEVEL_BED_CORNERS
  #define LEVEL_CORNERS_INSET 30    // (mm) An inset for corner leveling
  #define LEVEL_CORNERS_Z_HOP  4.0  // (mm) Move nozzle up before moving between corners
#define Z_SAFE_HOMING
  #define Z_SAFE_HOMING_X_POINT ((X_BED_SIZE) / 2)    // X point for Z homing when homing all axes (G28).
  #define Z_SAFE_HOMING_Y_POINT ((Y_BED_SIZE) / 2)    // Y point for Z homing when homing all axes (G28).
#define HOMING_FEEDRATE_XY (50*60)
#define HOMING_FEEDRATE_Z  (4*60)
#define EEPROM_SETTINGS // Enable for M500 and M501 commands
#define EEPROM_CHITCHAT   // Give feedback on EEPROM commands. Disable to save PROGMEM.
#define HOST_KEEPALIVE_FEATURE        // Disable this if your host doesn't like keepalive messages
#define DEFAULT_KEEPALIVE_INTERVAL 2  // Number of seconds between "busy" messages. Set with M113.
#define BUSY_WHILE_HEATING            // Some hosts require "busy" messages even during heating
#define PREHEAT_1_TEMP_HOTEND 200
#define PREHEAT_1_TEMP_BED     60
#define PREHEAT_1_FAN_SPEED     0 // Value from 0 to 255
#define PREHEAT_2_TEMP_HOTEND 240
#define PREHEAT_2_TEMP_BED    80
#define PREHEAT_2_FAN_SPEED     0 // Value from 0 to 255
#define PRINTJOB_TIMER_AUTOSTART
#define LCD_LANGUAGE en
#define DISPLAY_CHARSET_HD44780 JAPANESE
#define SDSUPPORT
#define REPRAP_DISCOUNT_SMART_CONTROLLER
#define SOFT_PWM_SCALE 0
#define SERVO_DELAY { 300 }
